arsenal007/klopik/schematics/image.gif

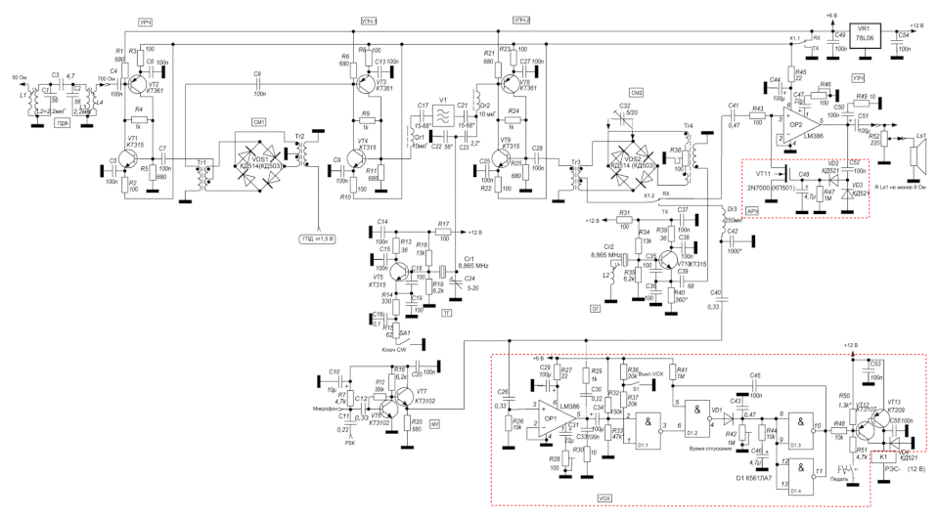
schematics/image.gif
