arsenal007/klopik/schematics/vox_847.gif

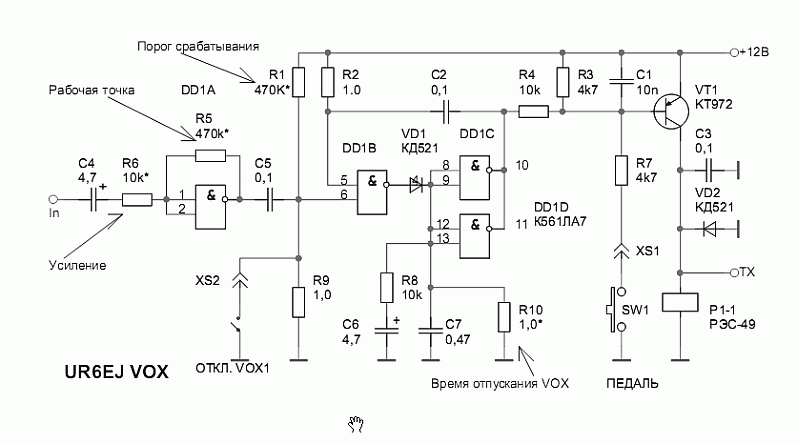
schematics/vox_847.gif
