arsenal007/klopik/PCB/TRX/KiCAD/TRX_klopik.pdf

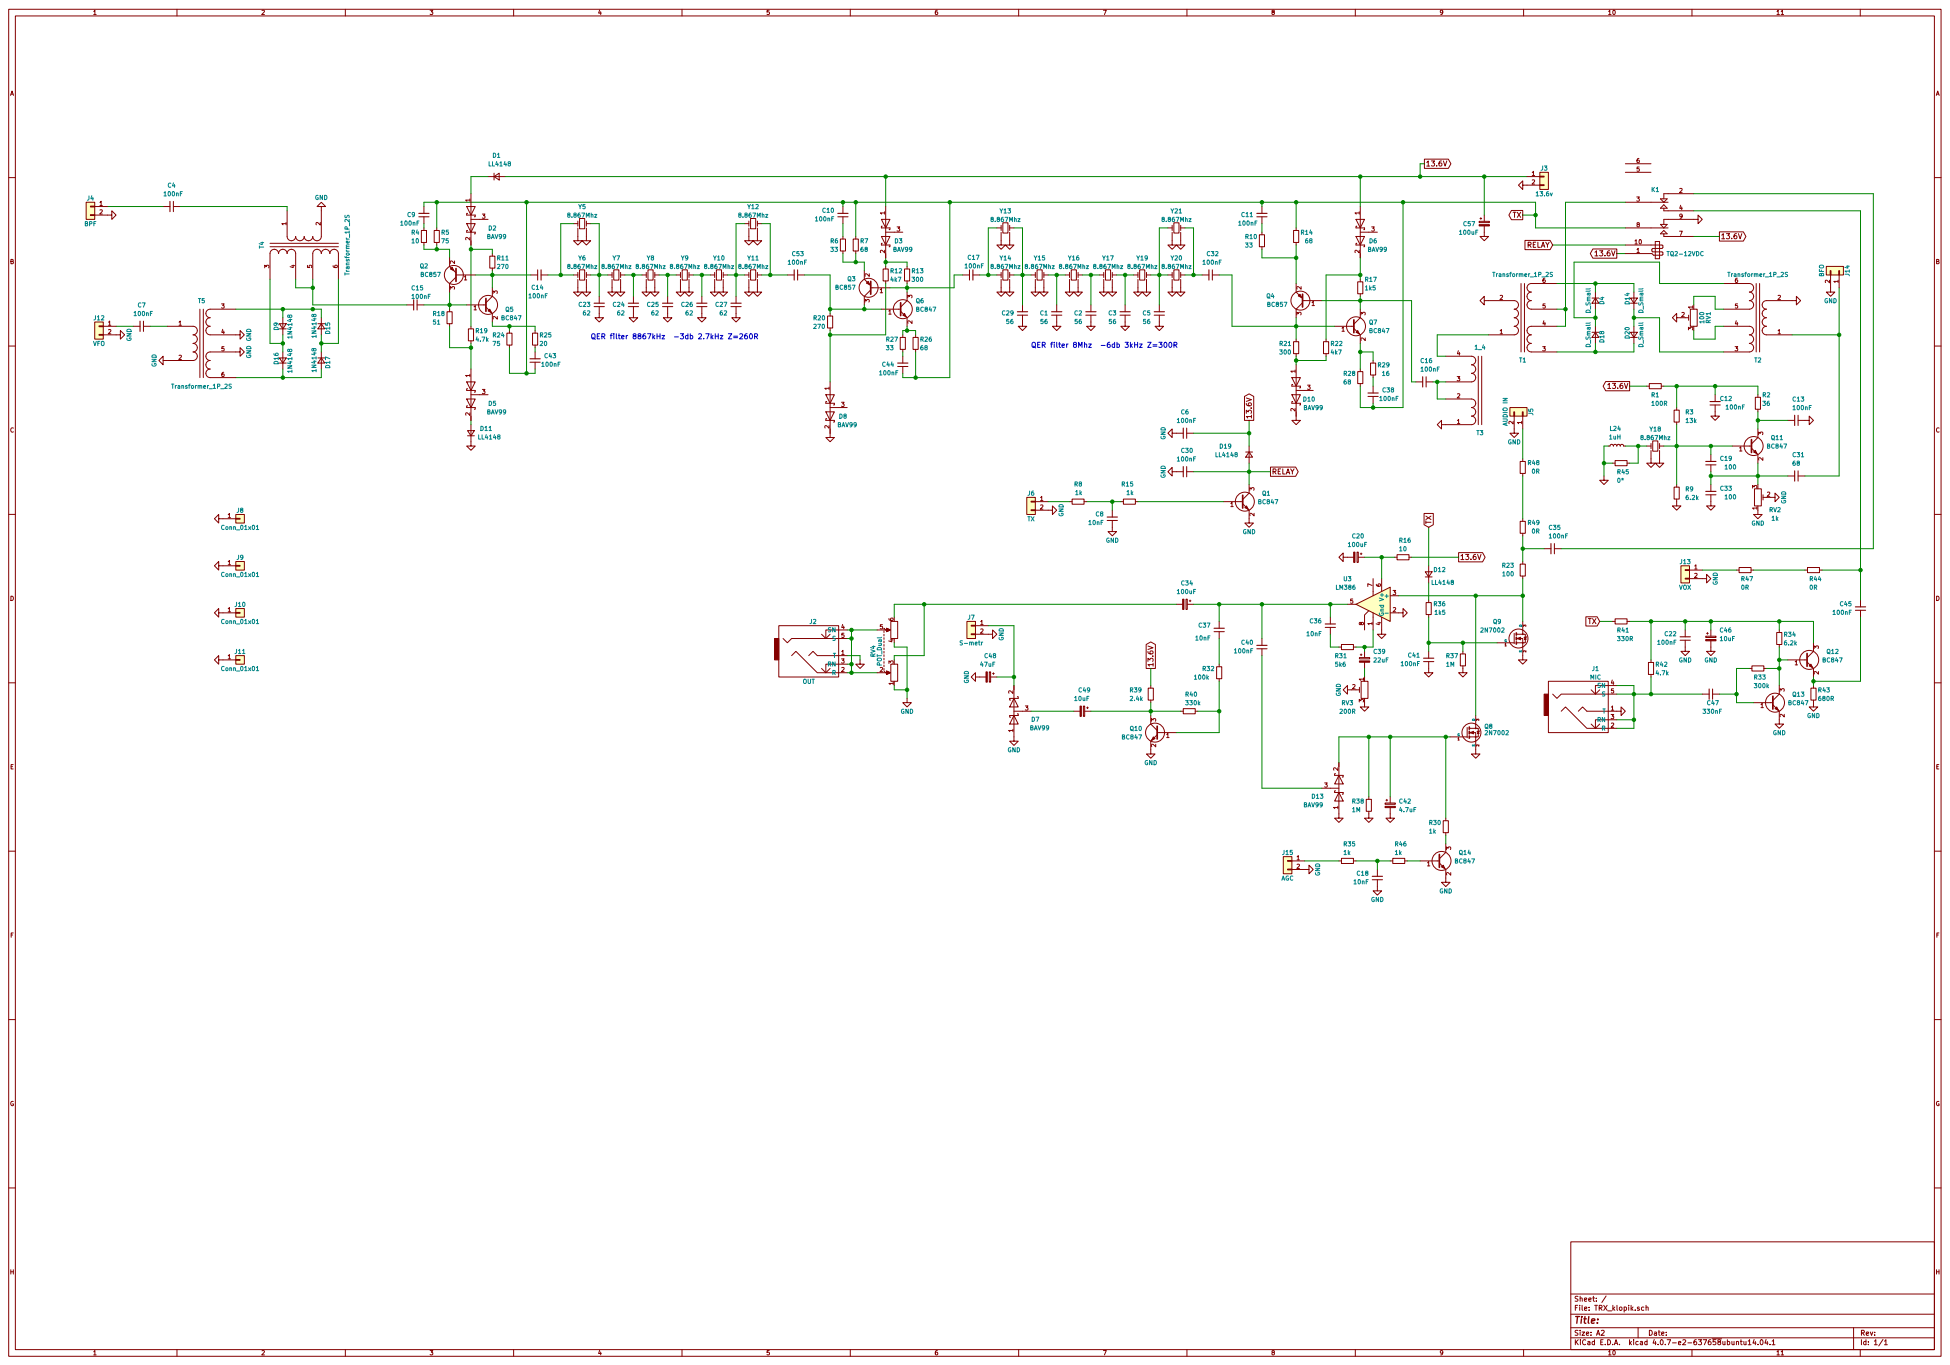
[picture p5: page 1]
