arsenal007/klopik/PCB/TRX/KiCAD/TRX_klopik.kicad_pcb

## KiCad design PCB/TRX/KiCAD/TRX_klopik.kicad_pcb (2018-05-19)

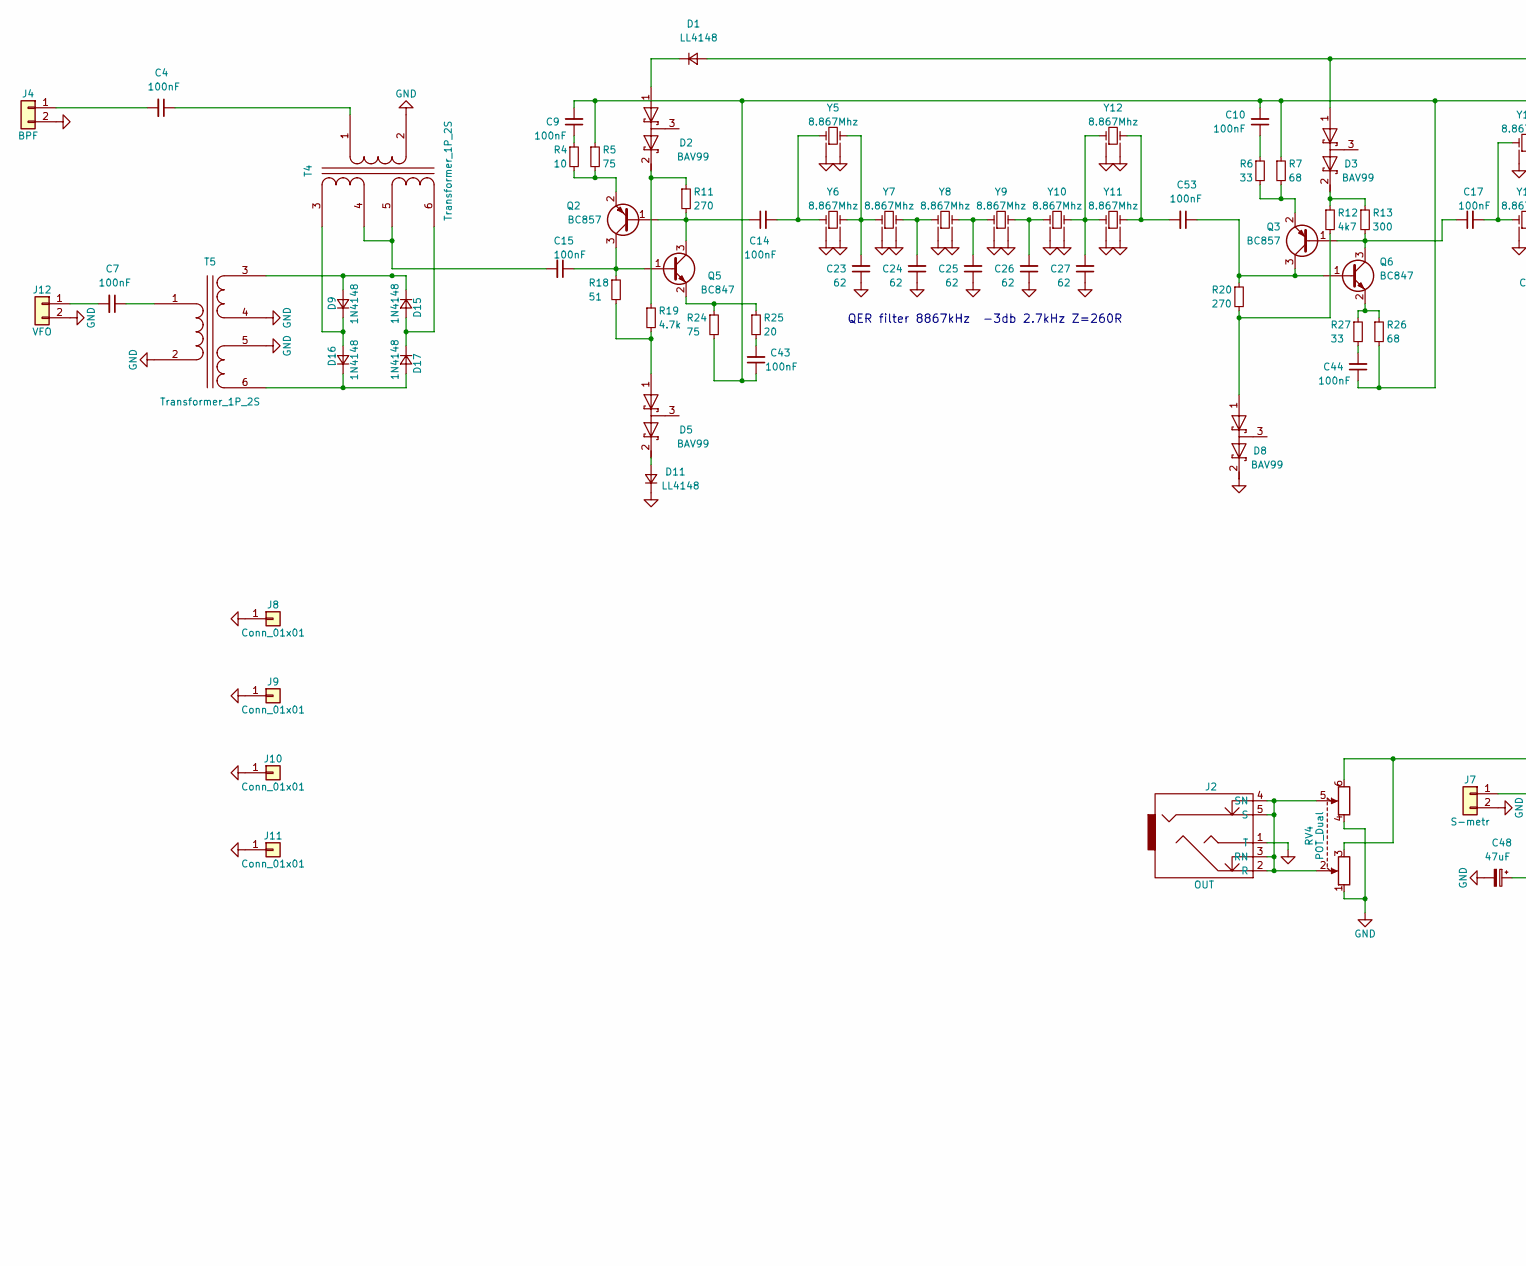
[picture p6: schematic TRX_klopik.sch, part in row 1, column 1]

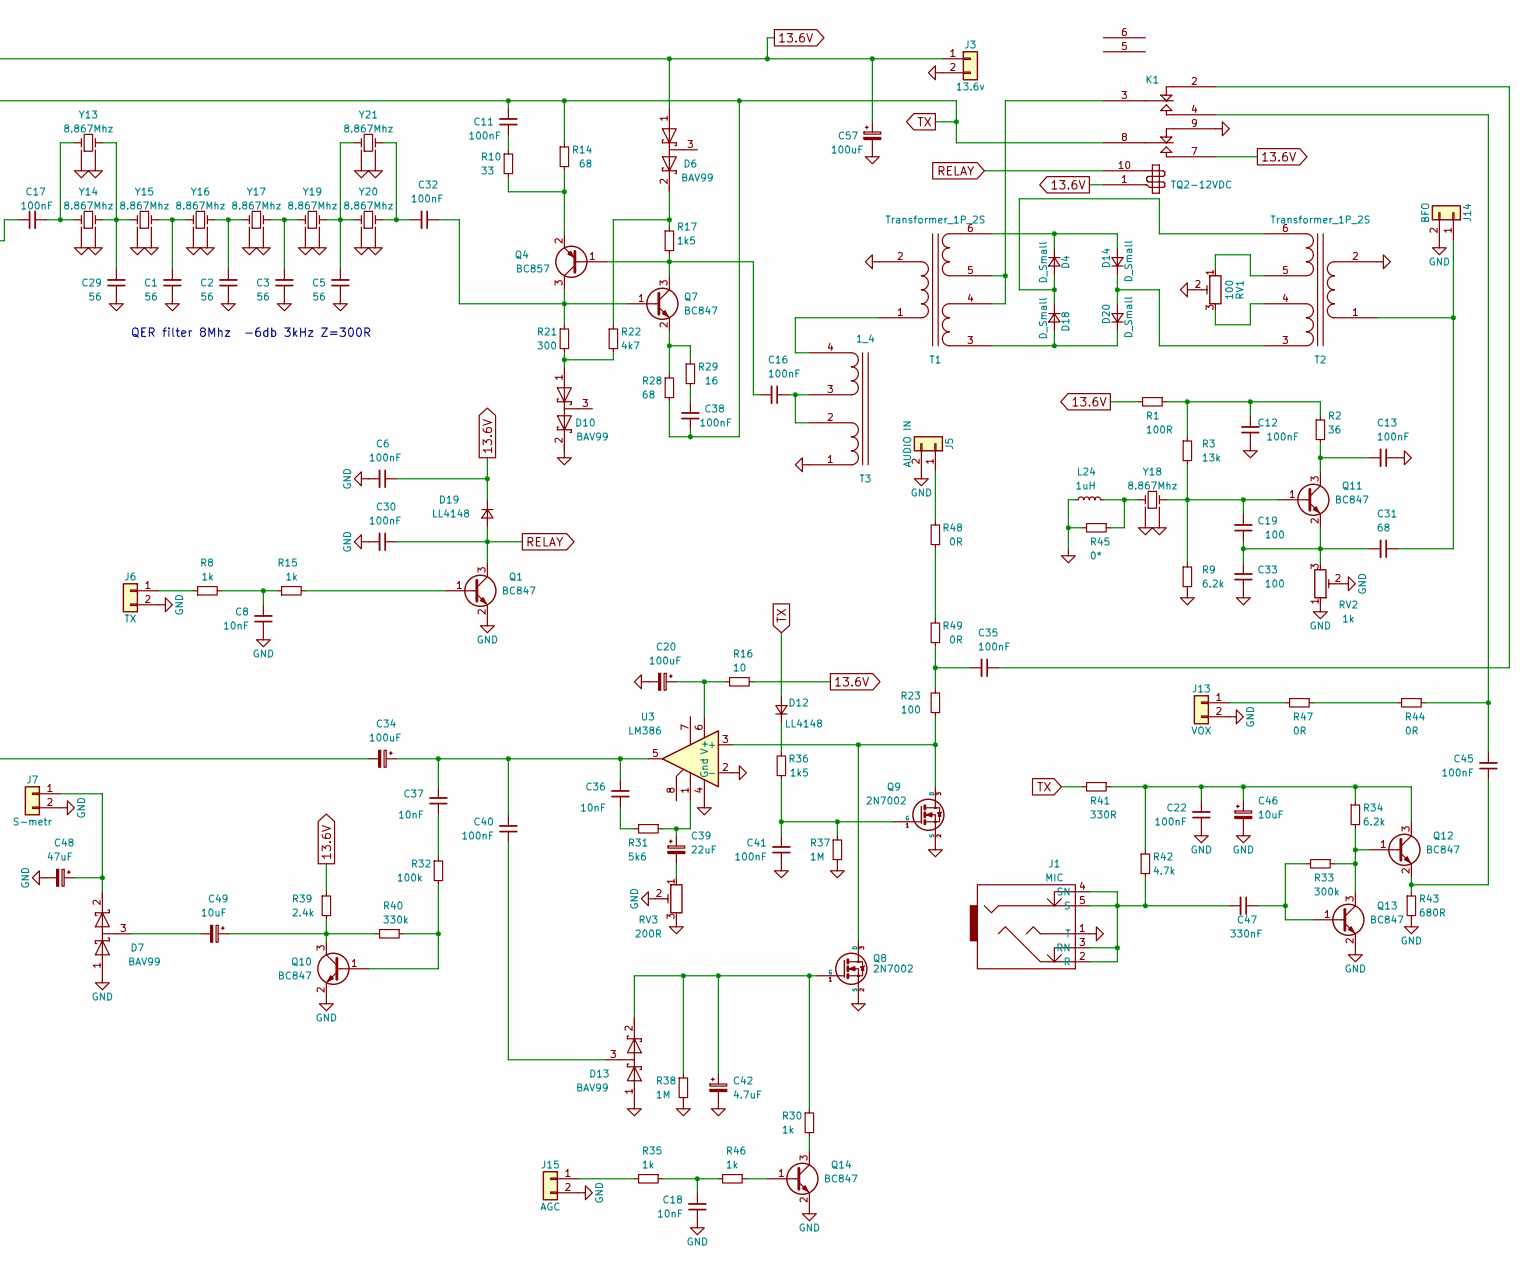
[picture p7: schematic TRX_klopik.sch, part in row 1, column 2]

Parts:
C1, C2, C3, C5, C29: 56; C_1206_0603
C4, C6, C7, C9, C10, C11, C12, C13, C14, C15, C16, C17, C22, C30, C32, C35, C38, C40, C41, C43, C44, C45, C53: 100nF; C_1206_0603
C8, C18, C37: 10nF; C_0603_HandSoldering
C19, C33: 100; C_1206_0603
C20, C34, C57: 100uF; CP_Radial_D6.3mm_P2.50mm
C23, C24, C25, C26, C27: 62; C_1206_0603
C31: 68; C_1206_0603
C36: 10nF; C_1206_0603
C39: 22uF; CP_Tantalum_Case-A_EIA-3216-18_Hand
C42: 4.7uF; CP_Tantalum_Case-A_EIA-3216-18_Hand
C46, C49: 10uF; CP_Tantalum_Case-A_EIA-3216-18_Hand
C47: 330nF; C_1206_0603
C48: 47uF; CP_Radial_D6.3mm_P2.50mm
D1, D11, D12, D19: LL4148; D_MiniMELF_Handsoldering
D2, D3, D5, D6, D7, D8, D10, D13: BAV99; SOT-23_Handsoldering
D4, D14, D18, D20: D_Small; D_DO-35_SOD27_P7.62mm_Horizontal
D9, D15, D16, D17: 1N4148; D_DO-35_SOD27_P7.62mm_Horizontal
J1: MIC; audio_jack_3_5mm_PJ307
J2: OUT; audio_jack_3_5mm_PJ307
J3: 13.6v; Pin_Header_Straight_1x02_Pitch2.54mm
J4: BPF; RFCONNECTOR
J5: AUDIO IN; Pin_Header_Straight_1x02_Pitch2.54mm
J6: TX; Pin_Header_Straight_1x02_Pitch2.54mm
J7: S-metr; Pin_Header_Straight_1x02_Pitch2.54mm
J8, J9, J10, J11: Conn_01x01; MountingHole_3.2mm_M3_DIN965_Pad
J12: VFO; RFCONNECTOR
J13: VOX; Pin_Header_Straight_1x02_Pitch2.54mm
J14: BFO; Pin_Header_Straight_1x02_Pitch2.54mm
J15: AGC; Pin_Header_Straight_1x02_Pitch2.54mm
K1: TQ2-12VDC; Relay_DPDT_FRT5
L24: 1uH; Choke_Toroid_6,5x13mm_Vertical
Q1, Q5, Q6, Q7, Q10, Q11, Q12, Q13, Q14: BC847; SOT-23_Handsoldering
Q2, Q3, Q4: BC857; SOT-23_Handsoldering
Q8, Q9: 2N7002; SOT-23_Handsoldering
R1: 100R; R_1206_0603
R2: 36; R_1206_0603
R3: 13k; R_1206_0603
R4, R16: 10; R_1206_0603
R5, R24: 75; R_1206_0603
R6, R10, R27: 33; R_1206_0603
R7, R14, R26, R28: 68; R_1206_0603
R8, R15, R30, R35, R46: 1k; R_1206_0603
R9, R34: 6.2k; R_1206_0603
R11, R20: 270; R_1206_0603
R12, R22: 4k7; R_0603_HandSoldering
R13, R21: 300; R_1206_0603
R17: 1k5; R_1206_0603
R18: 51; R_1206_0603
R19: 4.7k; R_0603_HandSoldering
R23: 100; R_1206_0603
R25: 20; R_1206_0603
R29: 16; R_1206_0603
R31: 5k6; R_1206_0603
R32: 100k; R_1206_0603
R33: 300k; R_1206_0603
R36: 1k5; R_0805_HandSoldering
R37, R38: 1M; R_1206_0603
R39: 2.4k; R_1206_0603
R40: 330k; R_1206_0603
R41: 330R; R_1206_0603
R42: 4.7k; R_1206_0603
R43: 680R; R_1206_0603
R44, R47, R48, R49: 0R; R_1206_0603
R45: 0*; R_1206_0603
RV1: 100; Potentiometer_Trimmer_Piher_PT-6v_Horizontal
RV2: 1k; Potentiometer_Trimmer_Piher_PT-6v_Horizontal
RV3: 200R; Potentiometer_Trimmer_Piher_PT-6v_Horizontal
RV4: POT_Dual; Potentiometer_WH148_Double
T1, T2, T4, T5: Transformer_1P_2S; HF_transf3
T3: 1_4; TF14
U3: LM386; SOIC-8_3.9x4.9mm_Pitch1.27mm
Y5, Y6, Y7, Y8, Y9, Y10, Y11, Y12, Y13, Y14, Y15, Y16, Y17, Y18, Y19, Y20, Y21: 8.867Mhz; Crystal_HC49-U_Vertical

Connections:
13.6V: C6.1, C57.1, D1.2 (A), D3.1 (A), D6.1 (A), D19.1 (K), J3.1, K1.1 (+), K1.7 (T1), R1.2, R16.1, R39.1
GND: C1.1, C2.1, C3.1, C5.1, C6.2, C8.1, C12.1, C13.1, C18.1, C20.2, C22.1, C23.1, C24.1, C25.1, C26.1, C27.1, C29.1, C30.2, C33.1, C41.1, C42.2, C46.2, C48.2, C57.2, D7.1 (A), D8.2 (K), D10.2 (K), D11.1 (K), D13.1 (A), J1.1 (T), J2.1 (T), J3.2, J4.2, J5.2, J6.2, J7.2, J8.1, J9.1, J10.1, J11.1, J12.2, J13.2, J14.2, J15.2, K1.9 (R1), L24.1, Q1.2 (E), Q8.2 (S), Q9.2 (S), Q10.2 (E), Q13.2 (E), Q14.2 (E), R9.2, R37.2, R38.2, R43.2, R45.2, RV1.2, RV2.1, RV2.2, RV3.2, RV3.3, RV4.1, RV4.4, T1.2 (AB), T2.2 (AB), T3.1 (SA), T4.2 (AB), T5.2 (AB), T5.4 (SB), T5.5 (SC), U3.2 (-), U3.4 (Gnd), Y5.3 (GND), Y5.4 (GND), Y6.3 (GND), Y6.4 (GND), Y7.3 (GND), Y7.4 (GND), Y8.3 (GND), Y8.4 (GND), Y9.3 (GND), Y9.4 (GND), Y10.3 (GND), Y10.4 (GND), Y11.3 (GND), Y11.4 (GND), Y12.3 (GND), Y12.4 (GND), Y13.3 (GND), Y13.4 (GND), Y14.3 (GND), Y14.4 (GND), Y15.3 (GND), Y15.4 (GND), Y16.3 (GND), Y16.4 (GND), Y17.3 (GND), Y17.4 (GND), Y18.3 (GND), Y18.4 (GND), Y19.3 (GND), Y19.4 (GND), Y20.3 (GND), Y20.4 (GND), Y21.3 (GND), Y21.4 (GND)
unnamed: C1.2, Y15.2, Y16.1
unnamed: C2.2, Y16.2, Y17.1
unnamed: C3.2, Y17.2, Y19.1
unnamed: C4.1, T4.1 (AA)
unnamed: C4.2, J4.1
unnamed: C5.2, Y19.2, Y20.1, Y21.1
unnamed: C7.1, T5.1 (AA)
unnamed: C7.2, J12.1
unnamed: C8.2, R8.2, R15.1
unnamed: C9.1, R4.1
unnamed: C10.1, R6.1
unnamed: C11.1, R10.1
unnamed: C12.2, R1.1, R2.1, R3.1
unnamed: C13.2, Q11.3 (C), R2.2
unnamed: C14.1, Q2.1 (B), Q5.3 (C), R11.2
unnamed: C14.2, Y5.1, Y6.1
unnamed: C15.1, Q2.3 (C), Q5.1 (B), R18.1
unnamed: C15.2, T4.4 (SB), T4.5 (SC)
unnamed: C16.1, T3.2 (SB), T3.3 (SC)
unnamed: C16.2, Q4.1 (B), Q7.3 (C), R17.2
unnamed: C17.1, Q3.1 (B), Q6.3 (C), R13.2
unnamed: C17.2, Y13.1, Y14.1
unnamed: C18.2, R35.1, R46.2
unnamed: C19.1, C31.2, C33.2, Q11.2 (E), RV2.3
unnamed: C19.2, Q11.1 (B), R3.2, R9.1, Y18.2
unnamed: C20.1, R16.2, U3.6 (V+)
unnamed: C22.2, C46.1, Q12.3 (C), R34.1, R41.1, R42.1
unnamed: C23.2, Y5.2, Y6.2, Y7.1
unnamed: C24.2, Y7.2, Y8.1
unnamed: C25.2, Y8.2, Y9.1
unnamed: C26.2, Y9.2, Y10.1
unnamed: C27.2, Y10.2, Y11.1, Y12.1
unnamed: C29.2, Y13.2, Y14.2, Y15.1
unnamed: C31.1, J14.1, T2.1 (AA)
unnamed: C32.1, Q4.3 (C), Q7.1 (B), R21.1
unnamed: C32.2, Y20.2, Y21.2
unnamed: C34.1, C36.2, C37.2, C40.2, U3.5
unnamed: C34.2, RV4.3, RV4.6
unnamed: C35.1, K1.2 (R2)
unnamed: C35.2, R23.2, R49.1
unnamed: C36.1, R31.2
unnamed: C37.1, R32.1
unnamed: C38.2, R29.2
unnamed: C39.1, R31.1, U3.1
unnamed: C39.2, RV3.1
unnamed: C40.1, D13.3 (common)
unnamed: C41.2, Q9.1 (G), R36.1, R37.1
unnamed: C42.1, D13.2 (K), Q8.1 (G), R30.1, R38.1
unnamed: C43.2, R25.2
unnamed: C44.2, R27.2
unnamed: C45.1, Q12.2 (E), R43.1
unnamed: C45.2, K1.4 (T2), R44.1
unnamed: C47.1, Q13.1 (B), R33.2
unnamed: C47.2, J1.2 (R), J1.3 (RN), J1.4 (SN), J1.5 (S), R42.2
unnamed: C48.1, D7.2 (K), J7.1
unnamed: C49.1, Q10.3 (C), R39.2, R40.2
unnamed: C49.2, D7.3 (common)
unnamed: C53.1, Q3.3 (C), Q6.1 (B), R20.1
unnamed: C53.2, Y11.2, Y12.2
unnamed: D1.1 (K), D2.1 (A)
unnamed: D2.2 (K), R11.1, R19.1
unnamed: D3.2 (K), R12.1, R13.1
unnamed: D5.1 (A), R18.2, R19.2
unnamed: D6.2 (K), R17.1, R22.1
unnamed: D8.1 (A), R12.2, R20.2
unnamed: D10.1 (A), R21.2, R22.2
unnamed: D5.2 (K), D11.2 (A)
unnamed: D12.1 (K), R36.2
unnamed: D14.1 (K), D20.2 (A), T2.3 (SA)
unnamed: D4.1 (K), D14.2 (A), T1.6 (SD)
unnamed: D9.2 (A), D15.1 (K), T5.3 (SA)
unnamed: D15.2 (A), D17.1 (K), T4.6 (SD)
unnamed: D16.1 (K), D17.2 (A), T5.6 (SD)
unnamed: D9.1 (K), D16.2 (A), T4.3 (SA)
unnamed: D4.2 (A), D18.1 (K), T2.6 (SD)
unnamed: D18.2 (A), D20.1 (K), T1.3 (SA)
unnamed: J2.2 (R), J2.3 (RN), J2.4 (SN), J2.5 (S), RV4.2, RV4.5
unnamed: J5.1, R48.2
unnamed: J6.1, R8.1
unnamed: J13.1, R47.2
unnamed: J15.1, R35.2
unnamed: K1.3 (C2), T1.4 (SB), T1.5 (SC)
unnamed: L24.2, R45.1, Y18.1
unnamed: Q1.1 (B), R15.2
unnamed: Q2.2 (E), R4.2, R5.2
unnamed: Q3.2 (E), R6.2, R7.2
unnamed: Q4.2 (E), R10.2, R14.2
unnamed: Q5.2 (E), R24.1, R25.1
unnamed: Q6.2 (E), R26.1, R27.1
unnamed: Q7.2 (E), R28.1, R29.1
unnamed: Q8.3 (D), Q9.3 (D), R23.1, U3.3 (+)
unnamed: Q10.1 (B), R32.2, R40.1
unnamed: Q12.1 (B), Q13.3 (C), R33.1, R34.2
unnamed: Q14.1 (B), R46.1
unnamed: Q14.3 (C), R30.2
unnamed: R44.2, R47.1
unnamed: R48.1, R49.2
unnamed: RV1.1, T2.5 (SC)
unnamed: RV1.3, T2.4 (SB)
unnamed: T1.1 (AA), T3.4 (SD)
RELAY: C30.1, D19.2 (A), K1.10 (-), Q1.3 (C)
TX: C9.2, C10.2, C11.2, C38.1, C43.1, C44.1, D12.2 (A), K1.8 (C1), R5.1, R7.1, R14.1, R24.2, R26.2, R28.2, R41.2

Notes on the sheet:
QER filter 8867kHz -3db 2.7kHz Z=260R
QER filter 8Mhz -6db 3kHz Z=300R

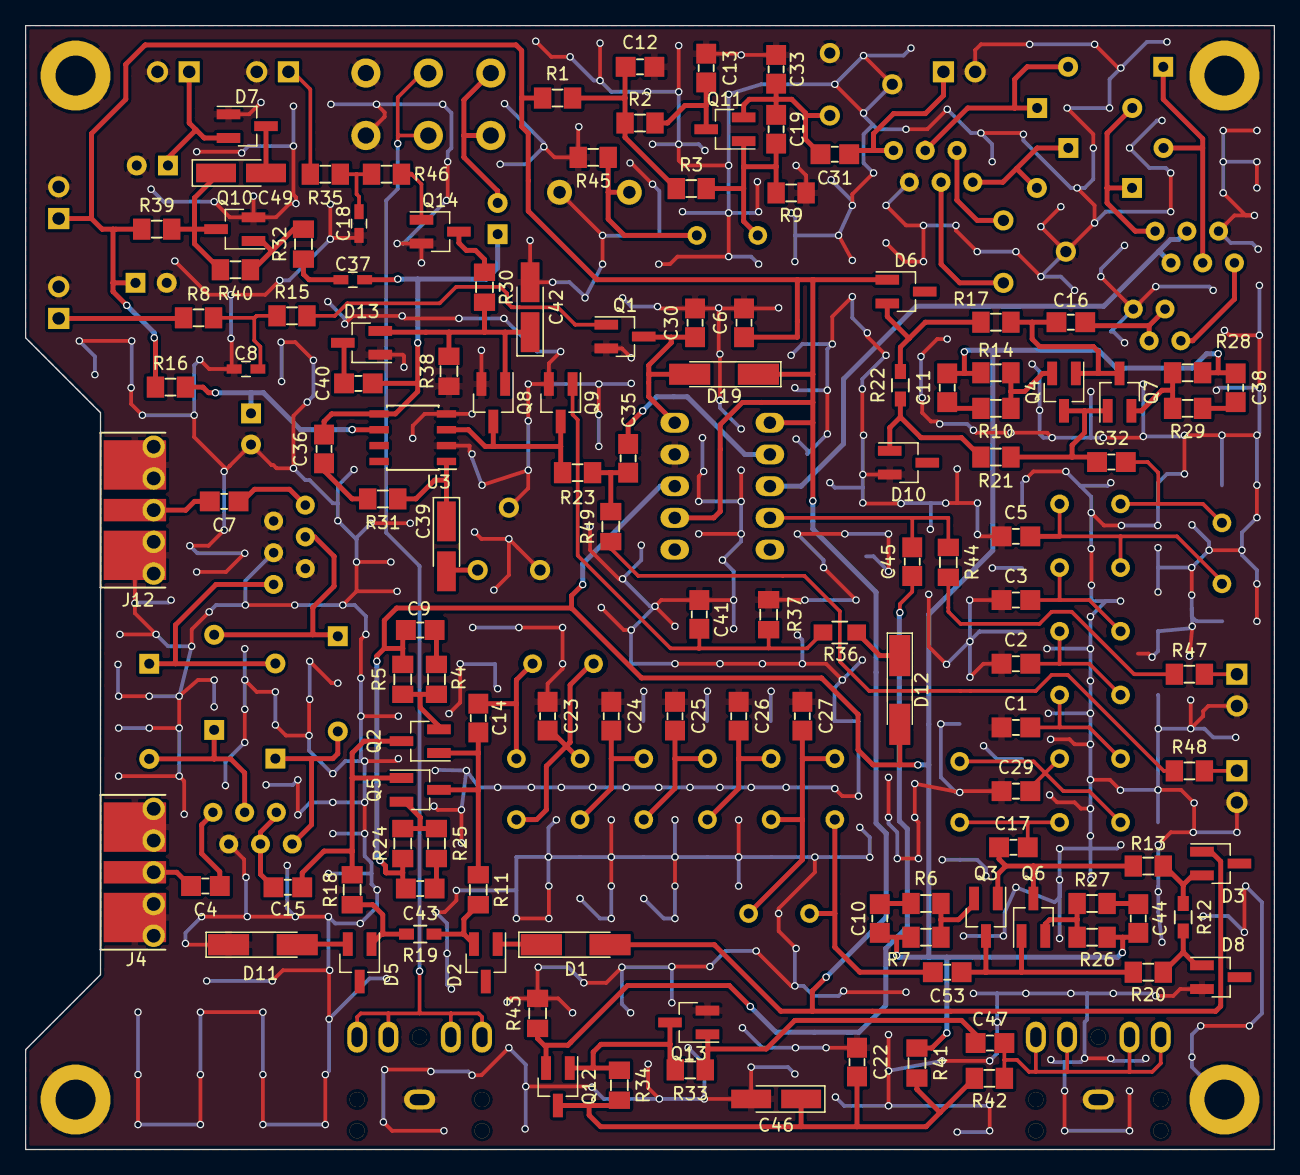
[picture p8: board TRX_klopik.kicad_pcb from above]

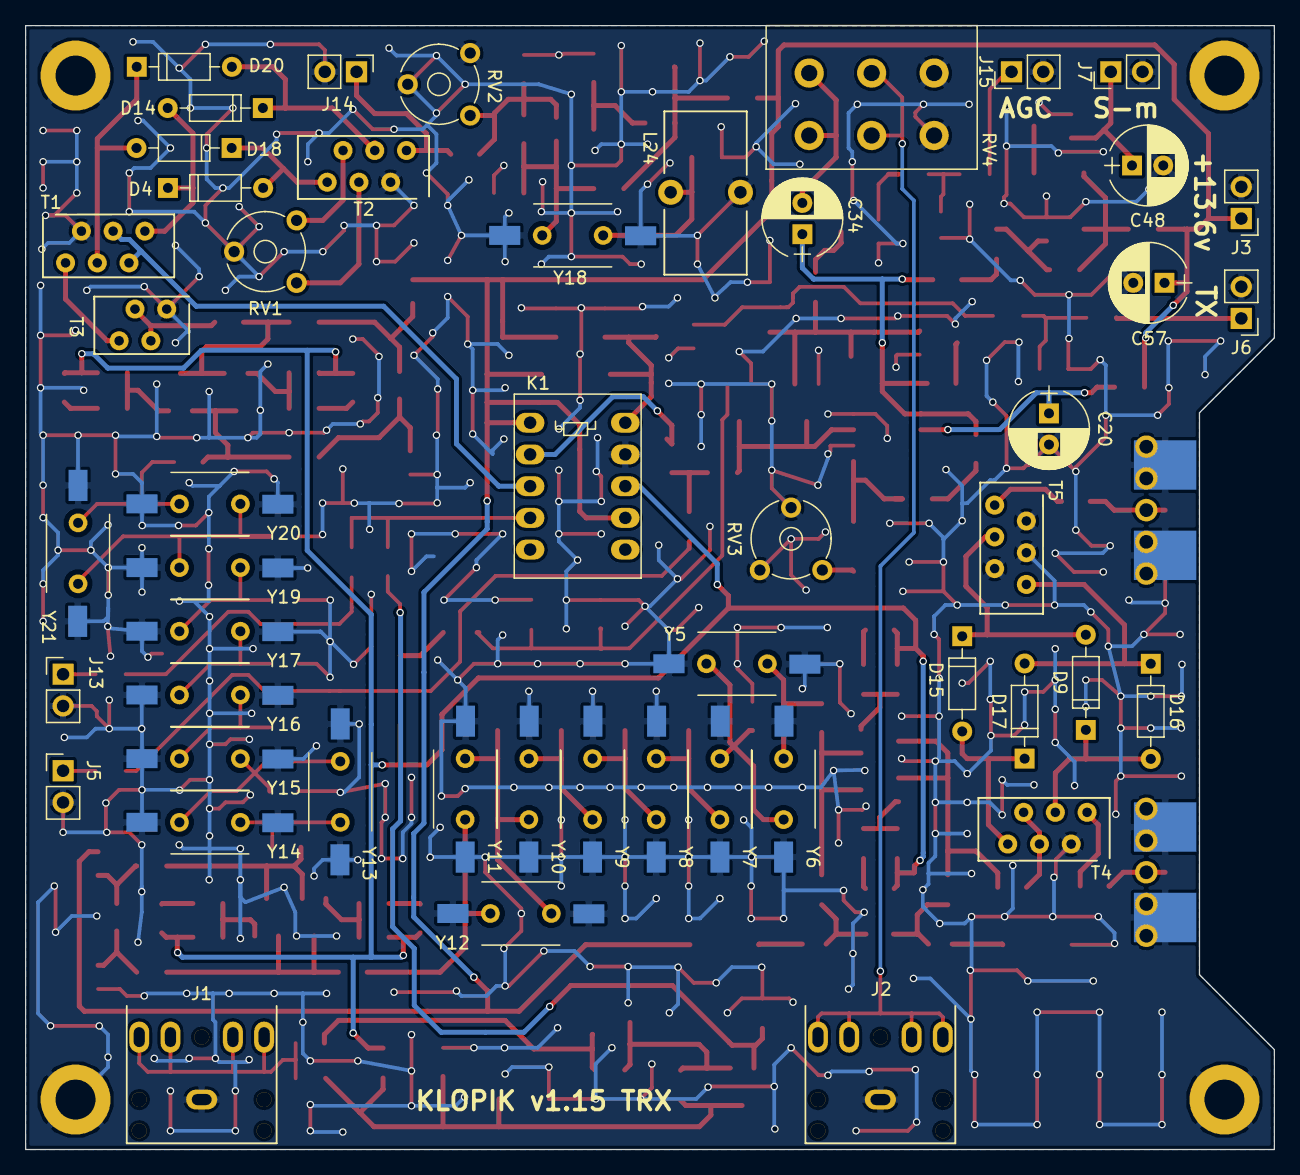
[picture p9: board TRX_klopik.kicad_pcb from below]

Board: 2 copper layers, 100.0 x 90.0 mm, 176 parts (51 on the bottom side), 104 nets.
