arsenal007/klopik/PCB/BPF/KiCAD/BPF.kicad_pcb

## KiCad design PCB/BPF/KiCAD/BPF.kicad_pcb (2018-05-19)

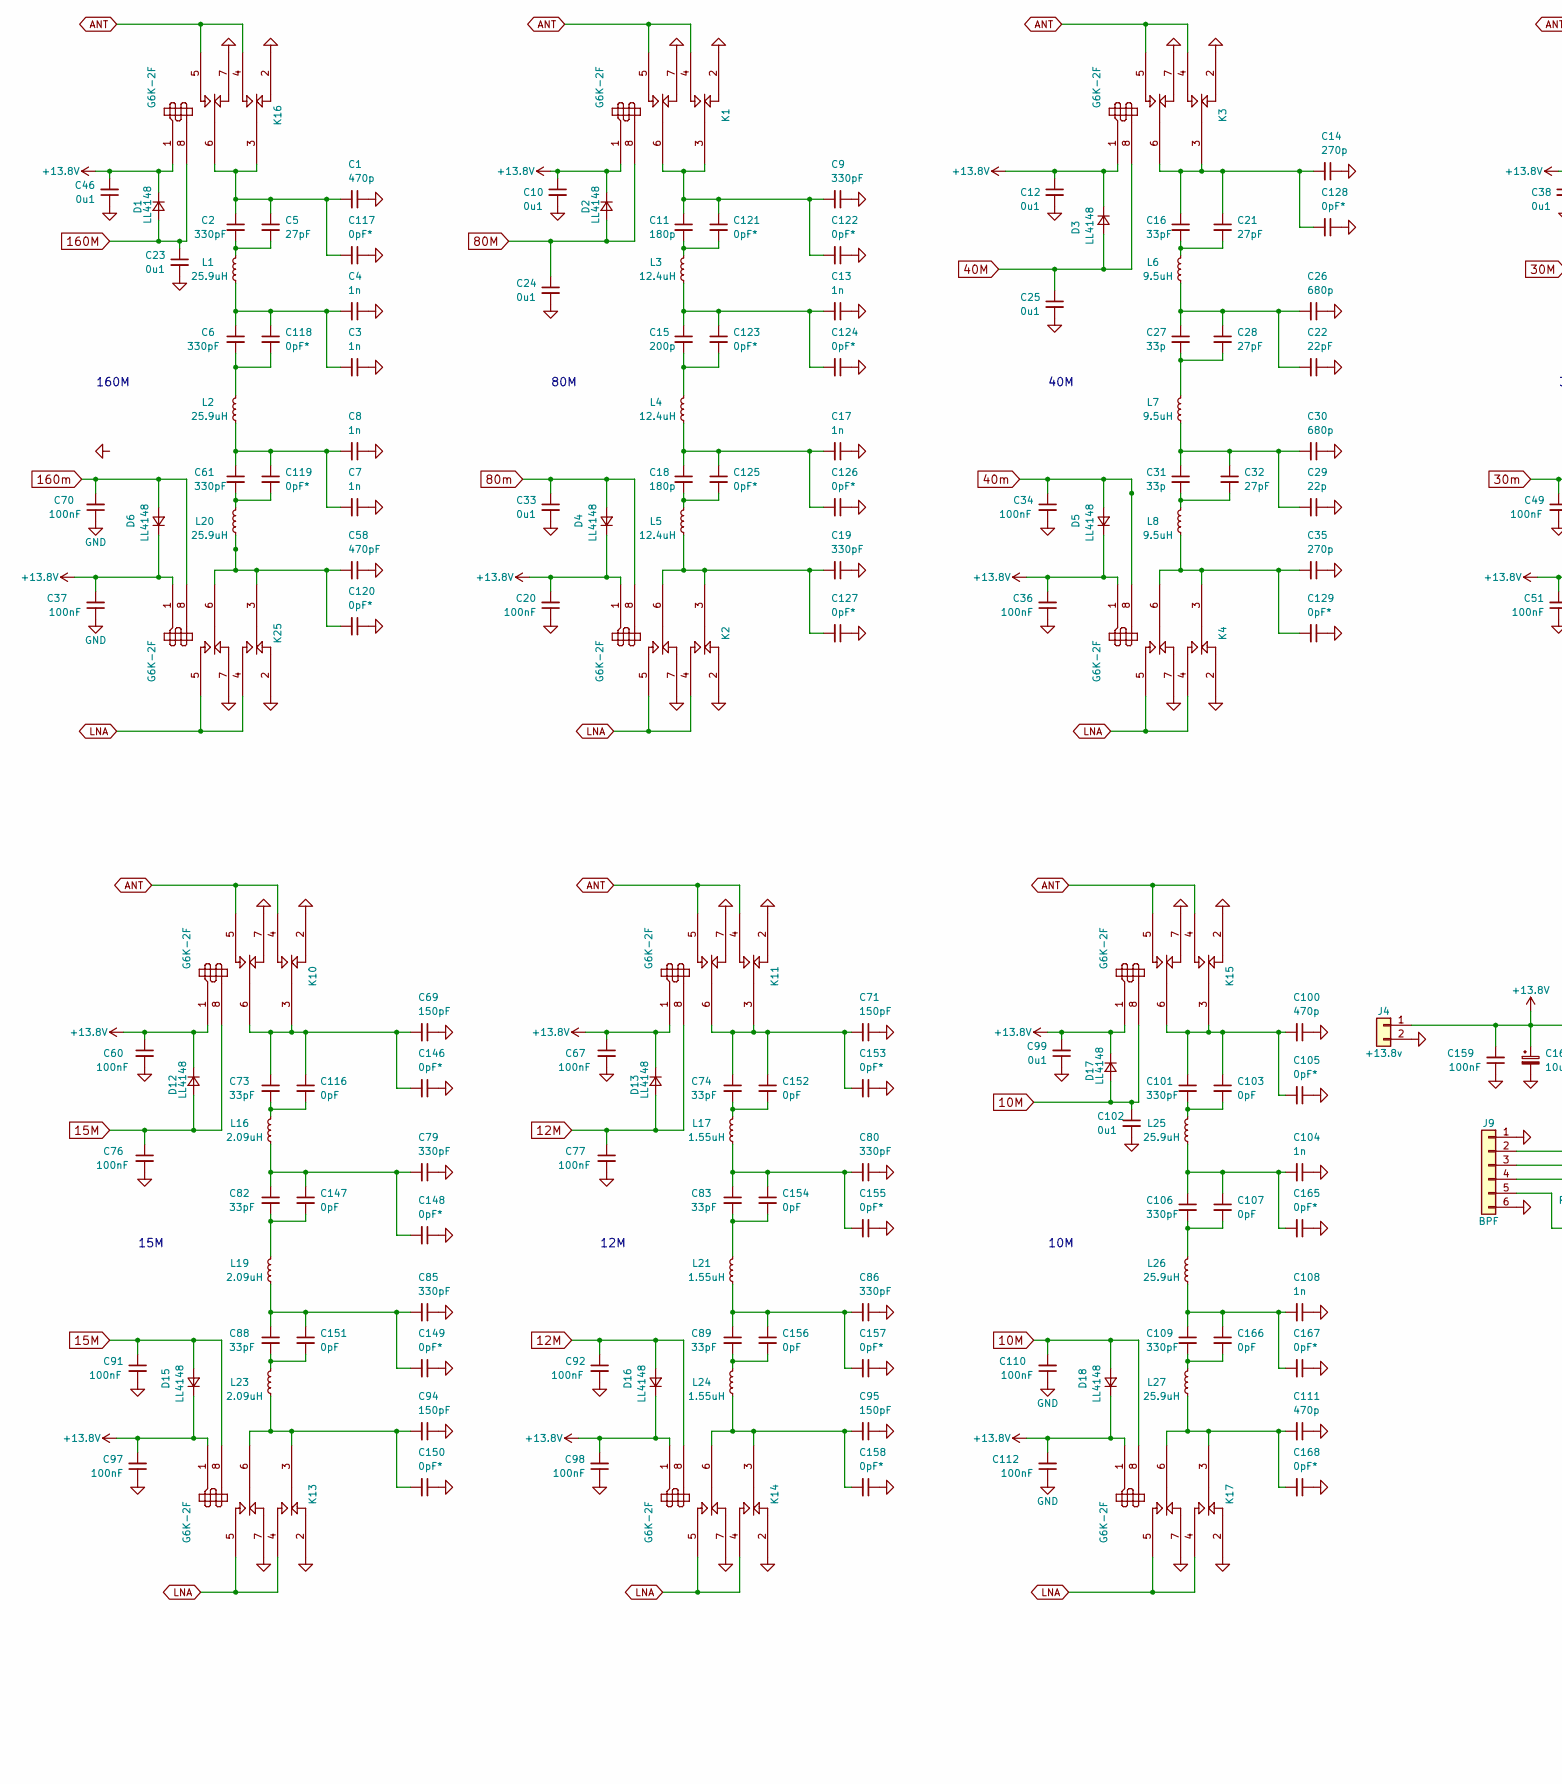
[picture p10: schematic BPF.sch, part in row 1, column 1]

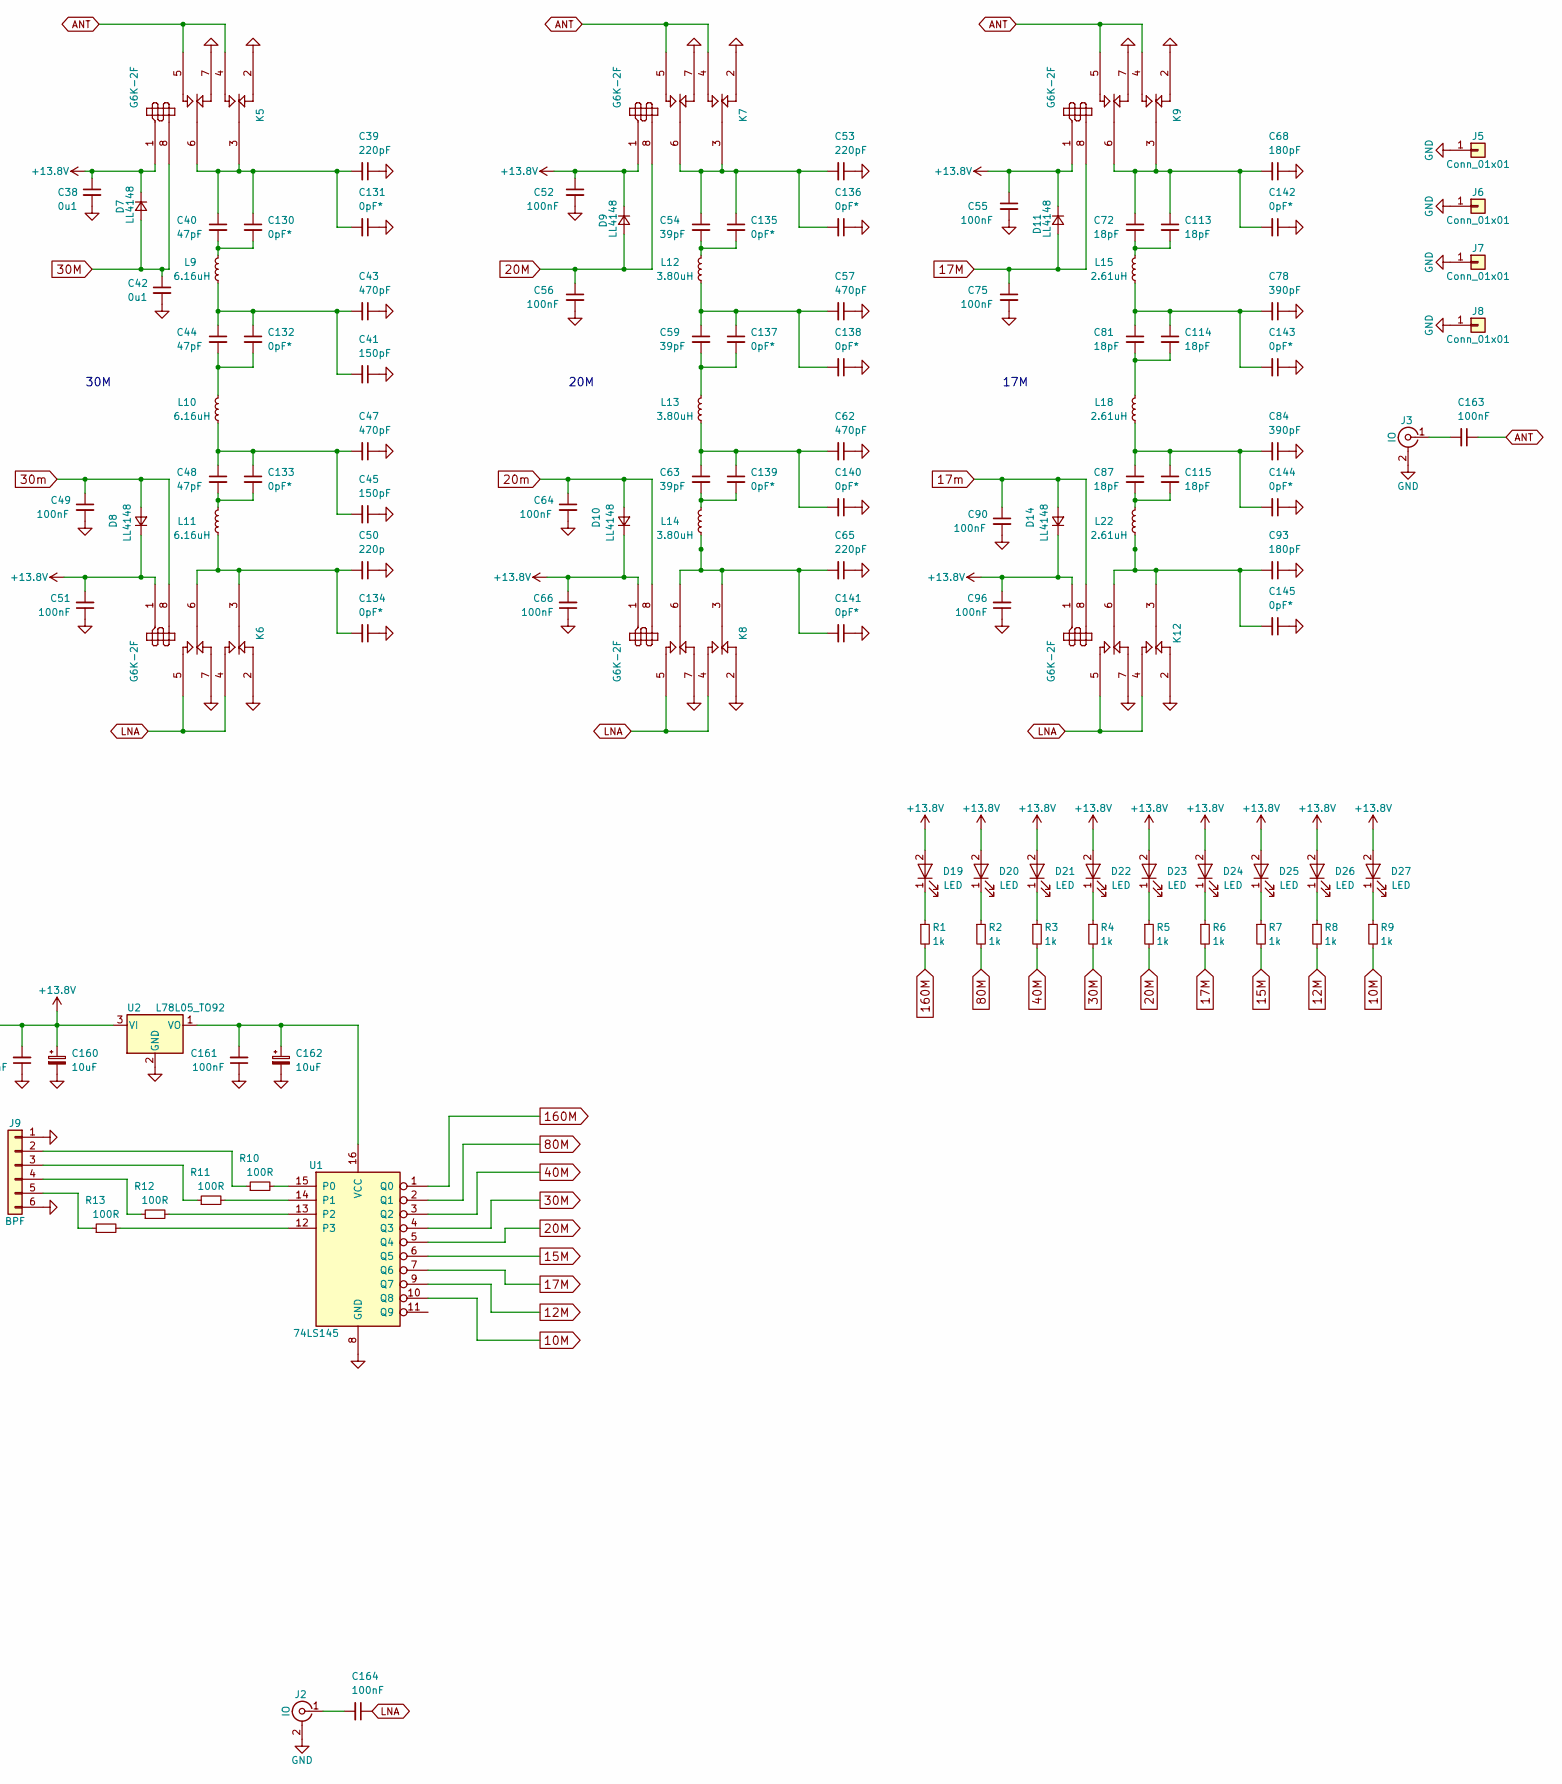
[picture p11: schematic BPF.sch, part in row 1, column 2]

Parts:
C1, C100, C111: 470p; C_1206_0603
C2, C6, C9, C19, C61, C79, C80, C85, C86, C101, C106, C109: 330pF; C_1206_0603
C3, C4, C7, C8, C13, C17, C104, C108: 1n; C_1206_0603
C5, C21, C28, C32: 27pF; C_1206_0603
C10, C12, C23, C24, C25, C33, C38, C42, C46, C99, C102: 0u1; C_1206_0603
C11, C18: 180p; C_1206_0603
C14, C35: 270p; C_1206_0603
C15: 200p; C_1206_0603
C16, C73, C74, C82, C83, C88, C89: 33pF; C_1206_0603
C20, C34, C36, C37, C49, C51, C52, C55, C56, C60, C64, C66, C67, C70, C75, C76, C77, C90, C91, C92, C96, C97, C98, C110, C112, C159, C161, C163, C164: 100nF; C_1206_0603
C22: 22pF; C_1206_0603
C26, C30: 680p; C_1206_0603
C27, C31: 33p; C_1206_0603
C29: 22p; C_1206_0603
C39, C53, C65: 220pF; C_1206_0603
C40, C44, C48: 47pF; C_1206_0603
C41, C45, C69, C71, C94, C95: 150pF; C_1206_0603
C43, C47, C57, C58, C62: 470pF; C_1206_0603
C50: 220p; C_1206_0603
C54, C59, C63: 39pF; C_1206_0603
C68, C93: 180pF; C_1206_0603
C72, C81, C87, C113, C114, C115: 18pF; C_1206_0603
C78, C84: 390pF; C_1206_0603
C103, C107, C116, C147, C151, C152, C154, C156, C166: 0pF; C_1206_0603
C105, C117, C118, C119, C120, C121, C122, C123, C124, C125, C126, C127, C128, C129, C130, C131, C132, C133, C134, C135, C136, C137, C138, C139, C140, C141, C142, C143, C144, C145, C146, C148, C149, C150, C153, C155, C157, C158, C165, C167, C168: 0pF*; C_1206_0603
C160, C162: 10uF; CP_Tantalum_Case-A_EIA-3216-18_Hand
D1, D2, D3, D4, D5, D6, D7, D8, D9, D10, D11, D12, D13, D14, D15, D16, D17, D18: LL4148; D_MiniMELF_Handsoldering
D19, D20, D21, D22, D23, D24, D25, D26, D27: LED; LED_D3.0mm
J2, J3: IO; RFCONNECTOR
J4: +13.8v; Pin_Header_Straight_1x02_Pitch2.54mm
J5, J6, J7, J8: Conn_01x01; MountingHole_3.2mm_M3_DIN965_Pad
J9: BPF; Pin_Header_Straight_1x06_Pitch2.54mm
K1, K2, K3, K4, K5, K6, K7, K8, K9, K10, K11, K12, K13, K14, K15, K16, K17, K25: G6K-2F; Relay_G6K-2F
L1, L2, L20, L25, L26, L27: 25.9uH; Choke_Toroid_6,5x13mm_Vertical
L3, L4, L5: 12.4uH; Choke_Toroid_6,5x13mm_Vertical
L6, L7, L8: 9.5uH; Choke_Toroid_6,5x13mm_Vertical
L9, L10, L11: 6.16uH; Choke_Toroid_6,5x13mm_Vertical
L12, L13, L14: 3.80uH; Choke_Toroid_6,5x13mm_Vertical
L15, L18, L22: 2.61uH; Choke_Toroid_6,5x13mm_Vertical
L16, L19, L23: 2.09uH; Choke_Toroid_6,5x13mm_Vertical
L17, L21, L24: 1.55uH; Choke_Toroid_6,5x13mm_Vertical
R1, R2, R3, R4, R5, R6, R7, R8, R9: 1k; R_1206_0603
R10, R11, R12, R13: 100R; R_0603_HandSoldering
U1: 74LS145; SOIC-16_3.9x9.9mm_Pitch1.27mm
U2: L78L05_TO92; TO-92_Inline_Wide

Connections:
10M: C102.1, C110.2, D17.2 (A), D18.2 (A), K15.8 (-), K17.8 (-), R9.2, U1.10 (Q8)
12M: C77.1, C92.1, D13.2 (A), D16.2 (A), K11.8 (-), K14.8 (-), R8.2, U1.9 (Q7)
15M: C76.1, C91.1, D12.2 (A), D15.2 (A), K10.8 (-), K13.8 (-), R7.2, U1.6 (Q5)
17M: C75.1, C90.1, D11.2 (A), D14.2 (A), K9.8 (-), K12.8 (-), R6.2, U1.7 (Q6)
20M: C56.1, C64.1, D9.2 (A), D10.2 (A), K7.8 (-), K8.8 (-), R5.2, U1.5 (Q4)
30M: C42.1, C49.1, D7.2 (A), D8.2 (A), K5.8 (-), K6.8 (-), R4.2, U1.4 (Q3)
40M: C25.1, C34.1, D3.2 (A), D5.2 (A), K3.8 (-), K4.8 (-), R3.2, U1.3 (Q2)
80M: C24.1, C33.1, D2.2 (A), D4.2 (A), K1.8 (-), K2.8 (-), R2.2, U1.2 (Q1)
160M: C23.1, C70.2, D1.2 (A), D6.2 (A), K16.8 (-), K25.8 (-), R1.2, U1.1 (Q0)
+13.8V: C10.1, C12.1, C20.2, C36.2, C37.2, C38.1, C46.2, C51.2, C52.1, C55.1, C60.1, C66.2, C67.1, C96.2, C97.2, C98.2, C99.2, C112.2, C159.2, C160.1, D1.1 (K), D2.1 (K), D3.1 (K), D4.1 (K), D5.1 (K), D6.1 (K), D7.1 (K), D8.1 (K), D9.1 (K), D10.1 (K), D11.1 (K), D12.1 (K), D13.1 (K), D14.1 (K), D15.1 (K), D16.1 (K), D17.1 (K), D18.1 (K), D19.2 (A), D20.2 (A), D21.2 (A), D22.2 (A), D23.2 (A), D24.2 (A), D25.2 (A), D26.2 (A), D27.2 (A), J4.1, K1.1 (+), K2.1 (+), K3.1 (+), K4.1 (+), K5.1 (+), K6.1 (+), K7.1 (+), K8.1 (+), K9.1 (+), K10.1 (+), K11.1 (+), K12.1 (+), K13.1 (+), K14.1 (+), K15.1 (+), K16.1 (+), K17.1 (+), K25.1 (+), U2.3 (VI)
ANT: C163.1, K1.4 (T2), K1.5 (T1), K3.4 (T2), K3.5 (T1), K5.4 (T2), K5.5 (T1), K7.4 (T2), K7.5 (T1), K9.4 (T2), K9.5 (T1), K10.4 (T2), K10.5 (T1), K11.4 (T2), K11.5 (T1), K15.4 (T2), K15.5 (T1), K16.4 (T2), K16.5 (T1)
GND: C1.1, C3.1, C4.1, C7.1, C8.1, C9.1, C10.2, C12.2, C13.1, C14.1, C17.1, C19.1, C20.1, C22.1, C23.2, C24.2, C25.2, C26.1, C29.1, C30.1, C33.2, C34.2, C35.1, C36.1, C37.1, C38.2, C39.1, C41.1, C42.2, C43.1, C45.1, C46.1, C47.1, C49.2, C50.1, C51.1, C52.2, C53.1, C55.2, C56.2, C57.1, C58.1, C60.2, C62.1, C64.2, C65.1, C66.1, C67.2, C68.1, C69.1, C70.1, C71.1, C75.2, C76.2, C77.2, C78.1, C79.1, C80.1, C84.1, C85.1, C86.1, C90.2, C91.2, C92.2, C93.1, C94.1, C95.1, C96.1, C97.1, C98.1, C99.1, C100.1, C102.2, C104.1, C105.1, C108.1, C110.1, C111.1, C112.1, C117.1, C120.1, C122.1, C124.1, C126.1, C127.1, C128.1, C129.1, C131.1, C134.1, C136.1, C138.1, C140.1, C141.1, C142.1, C143.1, C144.1, C145.1, C146.1, C148.1, C149.1, C150.1, C153.1, C155.1, C157.1, C158.1, C159.1, C160.2, C161.1, C162.2, C165.1, C167.1, C168.1, J2.2 (Ext), J3.2 (Ext), J4.2, J5.1, J6.1, J7.1, J8.1, J9.1, J9.6, K1.2 (R2), K1.7, K2.2 (R2), K2.7, K3.2 (R2), K3.7, K4.2 (R2), K4.7, K5.2 (R2), K5.7, K6.2 (R2), K6.7, K7.2 (R2), K7.7, K8.2 (R2), K8.7, K9.2 (R2), K9.7, K10.2 (R2), K10.7, K11.2 (R2), K11.7, K12.2 (R2), K12.7, K13.2 (R2), K13.7, K14.2 (R2), K14.7, K15.2 (R2), K15.7, K16.2 (R2), K16.7, K17.2 (R2), K17.7, K25.2 (R2), K25.7, U1.8 (GND), U2.2 (GND)
LNA: C164.1, K2.4 (T2), K2.5 (T1), K4.4 (T2), K4.5 (T1), K6.4 (T2), K6.5 (T1), K8.4 (T2), K8.5 (T1), K12.4 (T2), K12.5 (T1), K13.4 (T2), K13.5 (T1), K14.4 (T2), K14.5 (T1), K17.4 (T2), K17.5 (T1), K25.4 (T2), K25.5 (T1)
unnamed: C1.2, C2.1, C5.1, C117.2, K16.3 (C2), K16.6
unnamed: C2.2, C5.2, L1.2
unnamed: C9.2, C11.1, C121.1, C122.2, K1.3 (C2), K1.6
unnamed: C11.2, C121.2, L3.2
unnamed: C16.2, C21.2, L6.2
unnamed: C22.2, C26.2, C27.1, C28.1, L6.1
unnamed: C27.2, C28.2, L7.2
unnamed: C29.2, C30.2, C31.1, C32.1, L7.1
unnamed: C31.2, C32.2, L8.2
unnamed: C100.2, C101.1, C103.1, C105.2, K15.3 (C2), K15.6
unnamed: C101.2, C103.2, L25.2
unnamed: C104.2, C106.1, C107.1, C165.2, L25.1
unnamed: C106.2, C107.2, L26.2
unnamed: C108.2, C109.1, C166.1, C167.2, L26.1
unnamed: C109.2, C166.2, L27.2
unnamed: C111.2, C168.2, K17.3 (C2), K17.6, L27.1
unnamed: C68.2, C72.1, C113.1, C142.2, K9.3 (C2), K9.6
unnamed: C72.2, C113.2, L15.2
unnamed: C78.2, C81.1, C114.1, C143.2, L15.1
unnamed: C81.2, C114.2, L18.2
unnamed: C84.2, C87.1, C115.1, C144.2, L18.1
unnamed: C87.2, C115.2, L22.2
unnamed: C69.2, C73.1, C116.1, C146.2, K10.3 (C2), K10.6
unnamed: C73.2, C116.2, L16.2
unnamed: C3.2, C4.2, C6.1, C118.1, L1.1
unnamed: C6.2, C118.2, L2.2
unnamed: C7.2, C8.2, C61.1, C119.1, L2.1
unnamed: C61.2, C119.2, L20.2
unnamed: C58.2, C120.2, K25.3 (C2), K25.6, L20.1
unnamed: C13.2, C15.1, C123.1, C124.2, L3.1
unnamed: C15.2, C123.2, L4.2
unnamed: C17.2, C18.1, C125.1, C126.2, L4.1
unnamed: C18.2, C125.2, L5.2
unnamed: C19.2, C127.2, K2.3 (C2), K2.6, L5.1
unnamed: C14.2, C16.1, C21.1, C128.2, K3.3 (C2), K3.6
unnamed: C35.2, C129.2, K4.3 (C2), K4.6, L8.1
unnamed: C39.2, C40.1, C130.1, C131.2, K5.3 (C2), K5.6
unnamed: C40.2, C130.2, L9.2
unnamed: C41.2, C43.2, C44.1, C132.1, L9.1
unnamed: C44.2, C132.2, L10.2
unnamed: C45.2, C47.2, C48.1, C133.1, L10.1
unnamed: C48.2, C133.2, L11.2
unnamed: C50.2, C134.2, K6.3 (C2), K6.6, L11.1
unnamed: C53.2, C54.1, C135.1, C136.2, K7.3 (C2), K7.6
unnamed: C54.2, C135.2, L12.2
unnamed: C57.2, C59.1, C137.1, C138.2, L12.1
unnamed: C59.2, C137.2, L13.2
unnamed: C62.2, C63.1, C139.1, C140.2, L13.1
unnamed: C63.2, C139.2, L14.2
unnamed: C65.2, C141.2, K8.3 (C2), K8.6, L14.1
unnamed: C93.2, C145.2, K12.3 (C2), K12.6, L22.1
unnamed: C79.2, C82.1, C147.1, C148.2, L16.1
unnamed: C82.2, C147.2, L19.2
unnamed: C85.2, C88.1, C149.2, C151.1, L19.1
unnamed: C94.2, C150.2, K13.3 (C2), K13.6, L23.1
unnamed: C88.2, C151.2, L23.2
unnamed: C71.2, C74.1, C152.1, C153.2, K11.3 (C2), K11.6
unnamed: C74.2, C152.2, L17.2
unnamed: C80.2, C83.1, C154.1, C155.2, L17.1
unnamed: C83.2, C154.2, L21.2
unnamed: C86.2, C89.1, C156.1, C157.2, L21.1
unnamed: C89.2, C156.2, L24.2
unnamed: C95.2, C158.2, K14.3 (C2), K14.6, L24.1
unnamed: C161.2, C162.1, U1.16 (VCC), U2.1 (VO)
unnamed: C163.2, J3.1 (In)
unnamed: C164.2, J2.1 (In)
unnamed: D19.1 (K), R1.1
unnamed: D20.1 (K), R2.1
unnamed: D21.1 (K), R3.1
unnamed: D22.1 (K), R4.1
unnamed: D23.1 (K), R5.1
unnamed: D24.1 (K), R6.1
unnamed: D25.1 (K), R7.1
unnamed: D26.1 (K), R8.1
unnamed: D27.1 (K), R9.1
unnamed: J9.2, R10.1
unnamed: J9.3, R11.1
unnamed: J9.4, R12.1
unnamed: J9.5, R13.1
unnamed: R10.2, U1.15 (P0)
unnamed: R11.2, U1.14 (P1)
unnamed: R12.2, U1.13 (P2)
unnamed: R13.2, U1.12 (P3)

Notes on the sheet:
160M
80M
40M
30M
20M
17M
15M
12M
10M
