arsenal007/klopik/PCB/BPF/KiCAD/BPF.kicad_pcb

## KiCad design PCB/BPF/KiCAD/BPF.kicad_pcb (continued)

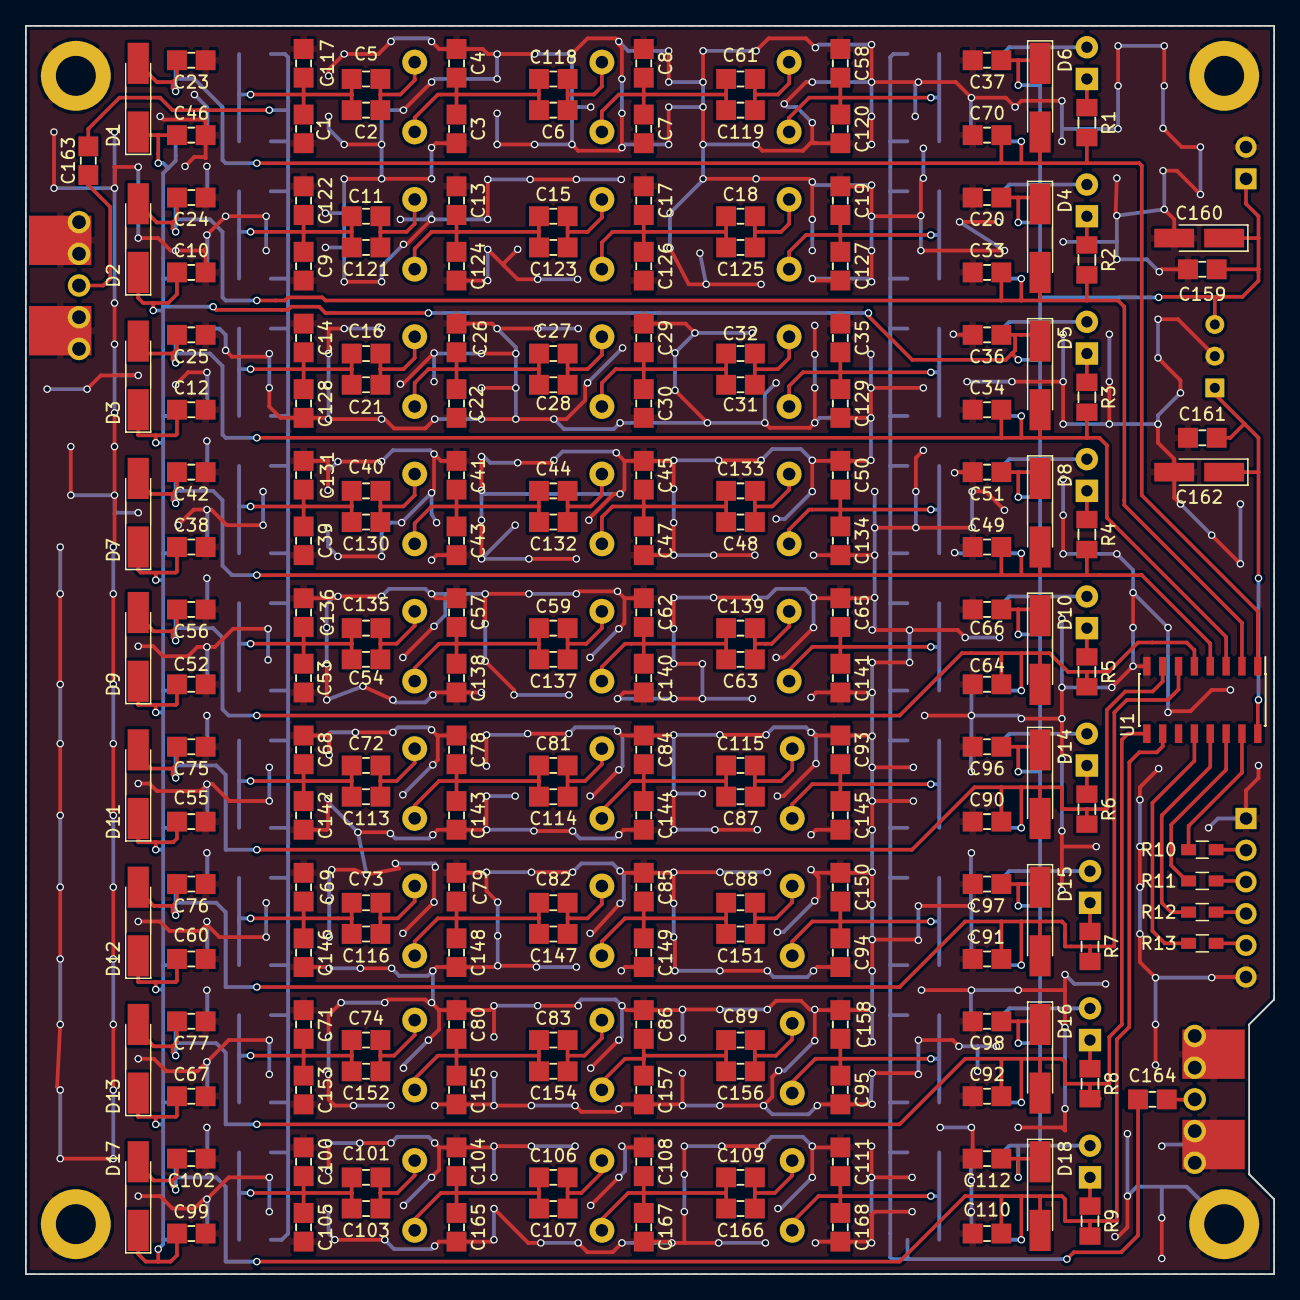
[picture p12: board BPF.kicad_pcb from above]

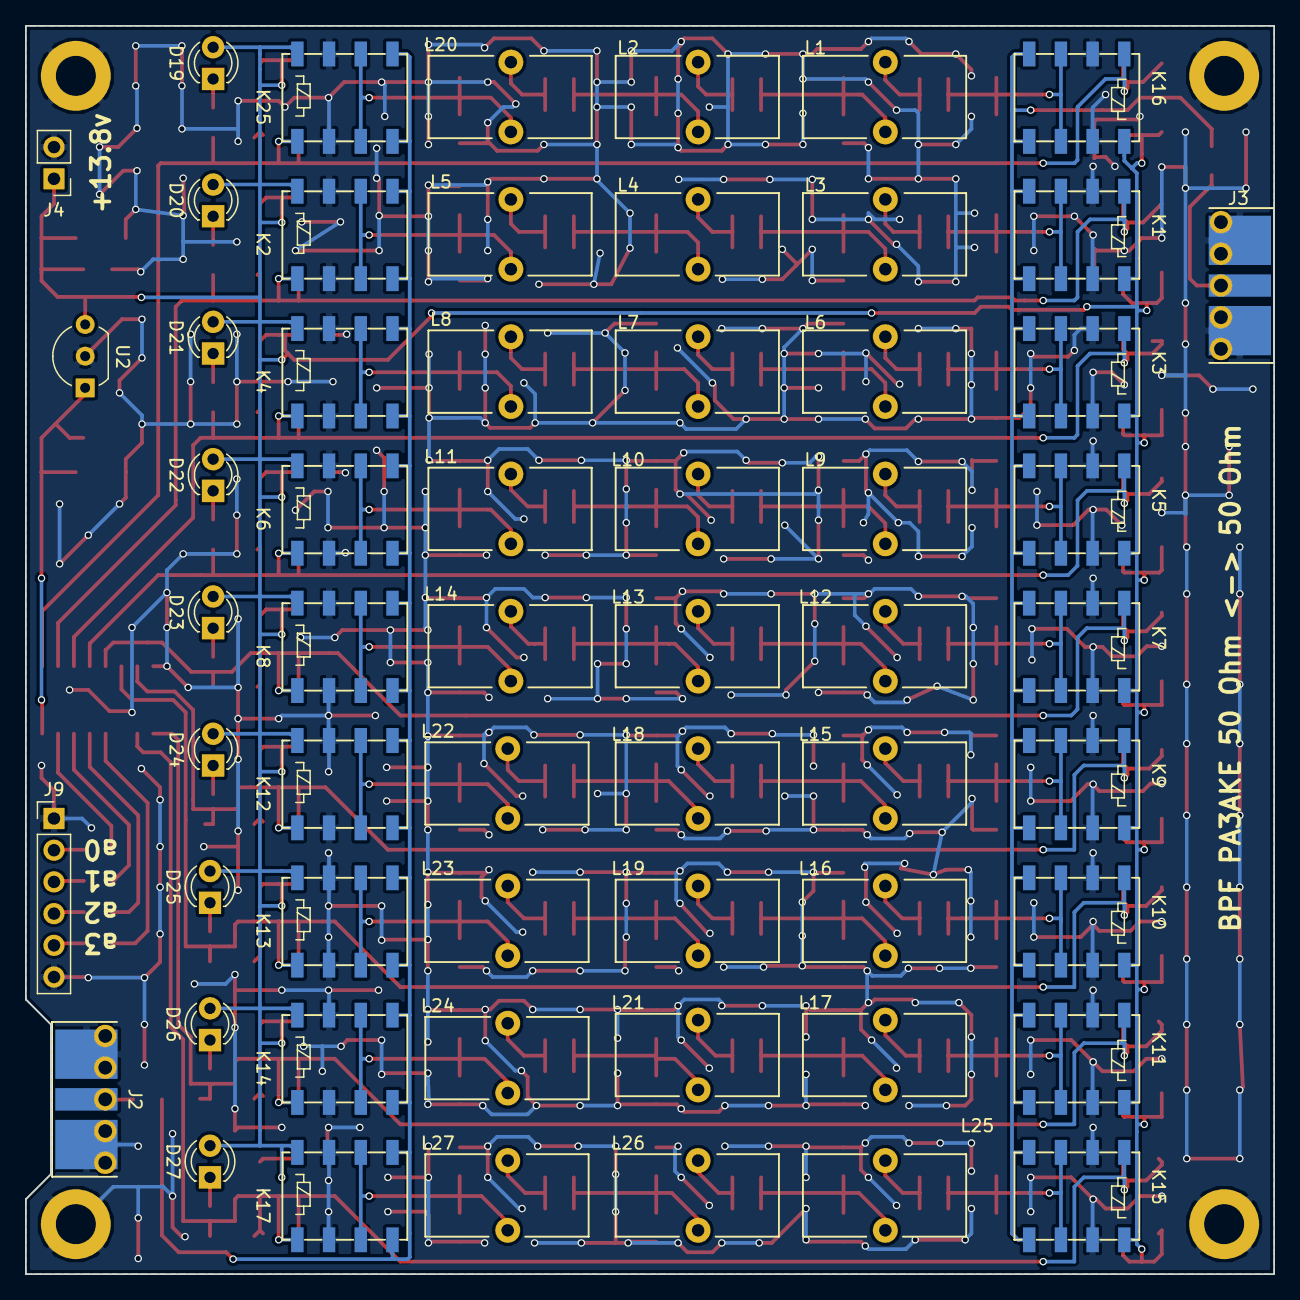
[picture p13: board BPF.kicad_pcb from below]

Board: 2 copper layers, 100.0 x 100.0 mm, 263 parts (59 on the bottom side), 96 nets.
