arsenal007/klopik/(commit log)

2018-04-30 TRX first commit with PCB
    [TRX_klopik-B.Cu.gbl, TRX_klopik-B.Mask.gbs, TRX_klopik-B.SilkS.gbo, TRX_klopik-Edge.Cuts.gm1, TRX_klopik-F.Cu.gtl, TRX_klopik-F.Mask.gts, TRX_klopik-F.SilkS.gto, TRX_klopik-NPTH.drl]
2018-05-10 add TRX PCB v1.15
    [TRX_klopik-B.Cu.gbl, TRX_klopik-B.Mask.gbs, TRX_klopik-B.SilkS.gbo, TRX_klopik-Edge.Cuts.gm1, TRX_klopik-F.Cu.gtl, TRX_klopik-F.Mask.gts, TRX_klopik-F.SilkS.gto, TRX_klopik.drl]
2018-05-19 add BPF PCB
    [BPF-B.Cu.gbl, BPF-B.Mask.gbs, BPF-B.SilkS.gbo, BPF-Edge.Cuts.gm1, BPF-F.Cu.gtl, BPF-F.Mask.gts, BPF-F.SilkS.gto, BPF.drl]
